polldo/Micro-game-board/microcontroller/inc/main.h

/*
 * main.h
 *
 *  Created on: 19 dic 2019
 *      Author: Poldo
 */

#ifndef MAIN_H_
#define MAIN_H_

#include <common.h>
#include <hw_debug_pin.h>
#include <refresh.h>
#include <sysclk.h>
#include <display.h>
#include <joystick.h>
#include <painter.h>
#include <note_player.h>
#include <sound.h>

#endif /* MAIN_H_ */
