polldo/Micro-game-board/microcontroller/hw/hw_joystick.h

/*
 * hw_joystick.h
 *
 *  Created on: 18 mar 2020
 *      Author: Poldo
 */

#ifndef HW_JOYSTICK_H_
#define HW_JOYSTICK_H_

#include <hw_common.h>

void TIM2_IRQHandler(void);
void hw_joystick_setup();

#endif /* HW_JOYSTICK_H_ */
