polldo/Micro-game-board/microcontroller/hw/sysclk.c

/*
 * sysclk.c
 *
 *  Created on: 19 dic 2019
 *      Author: Poldo
 */

#include <sysclk.h>

void SysTick_Handler(void)
{
  HAL_IncTick();
}

void sysclk_setup()
{
	/* SYSCLK: (HSI)16MHz * (N)10 / (R)2 = 80 MHz */
	__HAL_RCC_SYSCFG_CLK_ENABLE();
	__HAL_RCC_PWR_CLK_ENABLE();
	RCC_OscInitTypeDef RCC_OscInitStruct = {0};
	RCC_ClkInitTypeDef RCC_ClkInitStruct = {0};
	/* Initializes the CPU, AHB and APB busses clocks */
	RCC_OscInitStruct.OscillatorType = RCC_OSCILLATORTYPE_HSI;
	RCC_OscInitStruct.HSIState = RCC_HSI_ON;
	RCC_OscInitStruct.HSICalibrationValue = RCC_HSICALIBRATION_DEFAULT;
	RCC_OscInitStruct.PLL.PLLState = RCC_PLL_ON;
	RCC_OscInitStruct.PLL.PLLSource = RCC_PLLSOURCE_HSI;
	RCC_OscInitStruct.PLL.PLLM = 1;
	RCC_OscInitStruct.PLL.PLLN = 10;
	RCC_OscInitStruct.PLL.PLLP = RCC_PLLP_DIV7;
	RCC_OscInitStruct.PLL.PLLQ = RCC_PLLQ_DIV2;
	RCC_OscInitStruct.PLL.PLLR = RCC_PLLR_DIV2;
	HAL_RCC_OscConfig(&RCC_OscInitStruct);
	/* Initializes the CPU, AHB and APB busses clocks */
	RCC_ClkInitStruct.ClockType = RCC_CLOCKTYPE_HCLK|RCC_CLOCKTYPE_SYSCLK
			                      |RCC_CLOCKTYPE_PCLK1|RCC_CLOCKTYPE_PCLK2;
	RCC_ClkInitStruct.SYSCLKSource = RCC_SYSCLKSOURCE_PLLCLK;
	RCC_ClkInitStruct.AHBCLKDivider = RCC_SYSCLK_DIV1;
	RCC_ClkInitStruct.APB1CLKDivider = RCC_HCLK_DIV1;
	RCC_ClkInitStruct.APB2CLKDivider = RCC_HCLK_DIV1;
	HAL_RCC_ClockConfig(&RCC_ClkInitStruct, FLASH_LATENCY_4);
	/* Configure the main internal regulator output voltage */
	HAL_PWREx_ControlVoltageScaling(PWR_REGULATOR_VOLTAGE_SCALE1);
}
