polldo/Micro-game-board/microcontroller/inc/refresh.h

/*
 * refresh_timer.h
 *
 *  Created on: 19 dic 2019
 *      Author: Poldo
 */

#ifndef REFRESH_H_
#define REFRESH_H_

#include <common.h>

void refresh_setup();
void refresh_reset();
uint8_t refresh_get();

#endif /* REFRESH_H_ */
