polldo/Micro-game-board/microcontroller/hw/buttons.h

/*
 * buttons.h
 *
 *  Created on: 15 mar 2020
 *      Author: Poldo
 */

#ifndef BUTTONS_H_
#define BUTTONS_H_

/* HW PERIPHERALS USED:
 * 	TIM2 as timer to debounce input pins.
 * 	GPIOC port
 * 		- PIN 10 as Button A
 * 		- PIN 11 as Button B
 */



#endif /* BUTTONS_H_ */
