polldo/Micro-game-board/(commit log)

2019-12-13 Image format conversion - adapted to 128x64 oled
    -fixed display glitches by enlarging spi buffers
    -delayed display enable in order to correctly transmit even the first chunk of display buffer
    -received image is decoded as 128x64 oled format
    [spi_fifo.vhd, spi_rx.vhd, vga_datapath.vhd]
2019-12-19 minor changes
    - synchronous reset
    - resolution changed to 800x600 for compatibility reasons
    [memory_controller.vhd, spi.vhd, spi_controller.vhd, spi_fifo.vhd, spi_rx.vhd, top_entity.vhd, vga.vhd, vga_buffer.vhd]
2019-12-22 minor refactor - spi rx changed
    - spi receiver now uses the system clock to sample the spi clock and data, rather than just using processes following the spi clock directly
    - transfer acknowledge not anymore needed
2020-03-17 oled display - joystick - frame rate
    - oled display control implemented
    - joystick can be now used to check whether a button has been pressed right now or it is held down
    - frames per second have been lowered to 30
2020-03-18 Pin changed
    PC1, PC0 for buttons
    PB8 for SCL
    PB9 for SDA
